pritesh06303/2505_DataLogger/Input/Specification.docx

Project Name: Humidity Data Logger
Company: Innovation Device Solution (IDS)
Version: V0.0
Date: 23-09-2025

1. General Information

Parameter | Requirement
Device Type | Humidity & Temperature Data Logger
End Applications | Environmental monitoring, Industrial process, Agriculture, Storage/Cold Chain
Enclosure Rating | IP54 minimum
Compliance | CE / RoHS / EMC (IEC 61000-4-2/3)

2. Sensor Specifications

Parameter | Requirement
Sensor Model | TI HDC3022
Humidity Range | 0–100 %RH
Humidity Accuracy | ±2 %RH (20–80 %RH)
Humidity Resolution | 0.01 %RH
Temperature Range | -20 °C to +85 °C
Temperature Accuracy | ±0.5 °C (0–60 °C)
Temperature Resolution | 0.01 °C
Step Response (τ) | 4 s (63% RH step, moving air)
Long-Term Drift | ≤0.19 %RH/year

3. Logging & Storage

Parameter | Requirement
Logging Interval | 5s – 1 hr (configurable)
Memory Capacity | ≥64,000 readings
Data Type | Humidity, Temperature, Timestamp
RTC | Integrated with battery backup

4. Power & Battery

Parameter | Requirement
Battery Type | CR2450/2032 Coin Cell
Typical Battery Life | ≥1 year @ 15 min logging interval
Indicators | Low Battery Warning

5. User Interface

Parameter | Requirement
Display | LCD 3 ½ showing RH, Temp, Status
Buttons | 2 Keys (Start/Stop, Min/Max)
LED Indicators | Logging, Battery Low

6. Connectivity

Parameter | Requirement
USB | USB 2.0 (data transfer & config)
Data Export | CSV / PDF via PC Software

7. Software

Parameter | Requirement
IDS Logger PC Software | Configuration, Data Download, Visualization

8. Environmental Conditions

Parameter | Requirement
Operating Temp | -20 °C to +60 °C
Operating Humidity | 0–95 %RH (non-condensing)
Storage Conditions | -30 °C to +70 °C
