pritesh06303/2505_DataLogger/Input/IDS_Humidity_DataLogger.docx

Project Requirement Document (PRD)

Project Title: Humidity Data Logger
Company: Innovation Device Solution (IDS)
Prepared By:
Date: 23-09-2025

1. Introduction

The Humidity Data Logger is a compact, battery-powered device designed for environmental monitoring, industrial processes, agriculture, and storage applications. It integrates the HDC3022 humidity and temperature sensor for high accuracy and long-term stability.

2. Objectives

- Develop a reliable humidity and temperature data logger with ±2 %RH and ±0.5 °C accuracy.
- Ensure low-power operation for long battery life (minimum 1 year typical).
- Provide on-device storage (min. 64,000 readings) and USB for data retrieval.
- LCD 3 ½ digit for real-time monitoring.
- Enable calibration and firmware upgrade capability.

3. System Overview

The system consists of:

- Sensing Unit: HDC3022 sensor for humidity & temperature.
- Processing Unit: Low-power microcontroller (STM32L4 /U0).
- Data Storage: External EEPROM for at least 64000(32000 Temp +32000 % RH) logs.
- User Interface: LCD 3 ½ digit, 2-button keypad.
- Power Supply: Coin cell (CR 2450 or CR 2032)
- Connectivity: USB 2.0.
- Enclosure: Portable, vented for accurate humidity measurement – Mechanical

4. Functional Requirements

4.1 Measurement

- Humidity Range: 0–100 %RH
- Humidity Accuracy: ±2 %RH (20–80 %RH)
- Temperature Range: -20 °C to +60 °C
- Temperature Accuracy: ±0.1 °C (0–60 °C)
- Step Response (τ): 4 s (in moving air, 63% RH change)
- Resolution: 0.01 %RH / 0.01 °C

4.2 Logging & Storage

- Logging Interval: 5 s – 1 hr (configurable)
- Storage Capacity: ≥64,000 records (humidity + temperature + timestamp)
- Real-Time Clock (RTC) with battery backup

4.3 Power & Battery

- Battery Type: CR2450 /CR2032 coin cell
- Typical Battery Life: ≥1 year at 15 min logging interval
- Low-battery indication

4.4 User Interface

- LCD display: LCD 3 ½ digit showing Humidity, Temperature, Status
- Keypad: 2 buttons (Start/Stop , Min/Max)
- LED indication: Logging, Battery Low

4.5 Data Transfer

- USB 2.0 direct connection to PC
- Data format: CSV/PDF export via software

4.6 Software

- Logger PC software for data download, configuration, and visualization
- Firmware upgrade via USB

5. Non-Functional Requirements

- Operating Environment: -20 °C to +60 °C, 0–95 %RH non-condensing
- IP54 minimum enclosure, option for IP67 with sealed design
- EMC/ESD compliance (IEC 61000-4-2/3)
- Calibration certificate traceable to ISO 17025 (optional)

6. Deliverables

- Final product hardware design (schematic, PCB, enclosure)
- Firmware with logging, display, and communication features
- Logger PC software package
- Production test plan & calibration procedure
- User manual & datasheet

7. Timeline

- Week 1: Requirement freeze & block diagram
- Week 2-3: Hardware design & prototype
- Week 3-7: Firmware development & testing
- Week 8-10: Field testing & calibration
- Week11: Final release

8. Success Criteria

- Meets specified accuracy (±2 %RH, ±0.5 °C)
- Logs data continuously for ≥1 year battery life
- Easy data export to PC via USB
- Robust enclosure suitable for industrial and agricultural environments
