pritesh06303/2505_DataLogger/2505_IDS_DL_BAT_HW/Project Outputs for 2505_IDS_DL_BAT/BOM_2505_IDS_DL_BAT.xlsx

Sheet: BOM_2505_IDS_DL_BAT
Sr.No | Comment | Designator | Quantity | Manufacturer Name | Manufacturer Part No | Total Qty 10 | Total Qty 25 | Total Qty 50 | Total Qty 100 | Total Qty 500 | Total Qty 1000 | Price@10 | Price@25 | Price@50 | Price@100 | Price@500 | Price@1000 | Total Price@10 | Total Price@25 | Total Price@50 | Total Price@100 | Total Price@500 | Total Price@1000
1 | CAP CER 0.1UF 50V X7R 0603 | C1, C3, C4, C5, C6, C10, C11 | 7 | Samsung Electro-Mechanics | CL10B104KB8NNWC | 70 | 175 | 350 | 700 | 3500 | 7000 | 0.315 | 0.28 | 0.28 | 0.28 | 0.28 | 0.21 | 22.05 | 49 | 98 | 196 | 980 | 1470
2 | CAP CER 1UF 50V X7R 0805 | C2, C9, C12, C13 | 4 | Samsung Electro-Mechanics | CL21B105KBFNNNE / CL10A105KA8NNNC | 40 | 100 | 200 | 400 | 2000 | 4000 | 0.438 | 0.3763 | 0.3763 | 0.3763 | 0.3763 | 0.35 | 17.52 | 37.63 | 75.26 | 150.52 | 752.6 | 1400
3 | CAP CER 10PF 50V C0G/NP0 0603 | C7, C8 | 2 | Walsin Technology Corporation | 0603N100J500CT | 20 | 50 | 100 | 200 | 1000 | 2000 | 2.1 | 1.3826 | 1.1813 | 1.1813 | 0.721 | 0.721 | 42 | 69.13 | 118.13 | 236.26 | 721 | 1442
4 | DIODE SCHOTTKY 20V 1A SOD323 | D1, D6 | 2 | Nexperia USA Inc. | PMEG2010BEA | 20 | 50 | 100 | 200 | 1000 | 2000 | 19.25 | 19.25 | 11.655 | 11.655 | 7.39025 | 7.39025 | 385 | 962.5 | 1165.5 | 2331 | 7390.25 | 14780.5
5 | LED RED CLEAR SMD | D2, D3 | 2 |  |  | 20 | 50 | 100 | 200 | 1000 | 2000 | 7.963 | 7.963 | 5.5038 | 5.5038 | 4.347 | 3.962 | 159.26 | 398.15 | 550.38 | 1100.76 | 4347 | 7924
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
26 | Box Final Assembly |  | 1 |  |  | 10 | 25 | 50 | 100 | 500 | 1000 | 150 | 150 | 150 | 150 | 150 | 150 | 1500 | 3750 | 7500 | 15000 | 75000 | 150000
 |  |  |  |  |  |  |  |  |  |  |  |  |  |  |  |  | Total BOM Cost | 19526.67 | 44864.16 | 86139.87 | 162929.08 | 711589.22 | 1357342.42
 |  |  |  |  |  |  |  |  |  |  |  |  |  |  |  |  | Price /PCB | 1952.67 | 1794.57 | 1722.80 | 1629.29 | 1423.18 | 1357.34
 |  |  |  |  |  |  |  |  |  |  |  |  |  |  |  | PCB + Courier Charge |  | 20.00 | 26.68 | 37.38 | 62.02 | 181.04 | 327.85
 |  |  |  |  |  |  |  |  |  |  |  |  |  |  |  | Duty on PCB | 30% | 6.00 | 8.00 | 11.21 | 18.61 | 54.31 | 98.36
 |  |  |  |  |  |  |  |  |  |  |  |  |  |  |  | Surcharge | 15% | 0.90 | 1.20 | 1.68 | 2.79 | 8.15 | 14.75
 |  |  |  |  |  |  |  |  |  |  |  |  |  |  |  | SGST | 18% | 1.24 | 1.66 | 2.32 | 3.85 | 11.24 | 20.36
 |  |  |  |  |  |  |  |  |  |  |  |  |  |  |  | Total Surcharge |  | 8.14 | 10.86 | 15.22 | 25.25 | 73.70 | 133.47
 |  |  |  |  |  |  |  |  |  |  |  |  |  |  |  | Total PCB Price |  | 28.14 | 37.54 | 52.60 | 87.27 | 254.74 | 461.32
 |  |  |  |  |  |  |  |  |  |  |  |  |  |  |  | Price/ PCB |  | 2.81 | 1.50 | 1.05 | 0.87 | 0.51 | 0.46
 |  |  |  |  |  |  |  |  |  |  |  |  |  |  |  | USD Price | 88 | 247.65 | 132.15 | 92.57 | 76.80 | 44.83 | 40.60
 |  |  |  |  |  |  |  |  |  |  |  |  |  |  |  |  | 2476.496
 |  |  |  |  |  |  |  |  |  |  |  |  |  |  |  |  | 40 | 781.06696 | 717.8264906 | 689.1189682 | 651.7163124 | 569.2713774 | 542.9369683
 |  |  |  |  |  |  |  |  |  |  |  |  |  |  |  |  | Total Price | 2733.73436 | 2512.392717 | 2411.916389 | 2281.007093 | 1992.449821 | 1900.279389
 |  |  |  |  |  |  |  |  |  |  |  |  |  |  |  |  |  | 781066.96 | 717826.4906 | 689118.9682 | 651716.3124 | 569271.3774 | 542936.9683
 |  |  |  |  |  |  |  |  |  |  |  |  |  |  |  |  |  | 158.1011734 | 8.09667706
 |  |  |  |  |  |  |  |  |  |  |  |  |  |  |  |  |  | 229.8699795 | 11.77210105
 |  |  |  |  |  |  |  |  |  |  |  |  |  |  |  |  |  | 323.376619 | 16.56076294
 |  |  |  |  |  |  |  |  |  |  |  |  |  |  |  |  |  | 529.4889564 | 27.11618765 |  | S
 |  |  |  |  |  |  |  |  |  |  |  |  |  |  |  |  |  | 595.3249793 | 30.48778196

Sheet: BOM_2505_IDS_DL_PROD
Sr.No | Comment | Designator | Quantity
1 | CAP CER 0.1UF 50V X7R 0603 | C1, C3, C4, C5, C6, C10, C11 | 7
2 | CAP CER 1UF 50V X7R 0805 | C2, C9, C12, C13 | 4
3 | CAP CER 10PF 50V C0G/NP0 0603 | C7, C8 | 2
4 | DIODE SCHOTTKY 20V 1A SOD323 | D1, D6 | 2
5 | LED RED CLEAR SMD | D2, D3 | 2
7 | TVS DIODE 5.5VWM 8.5VC SOT23-5 | D5 | 1
8 | USB-C REC 3" VERT 24P SMT & TH S | J1 | 1
10 | RES 100K OHM 1% 1/10W 0603 | R1 | 1
11 | RES 0 OHM JUMPER - 0402 | R2, R13, R16 | 3
12 | RES 10K OHM 1% 1/10W 0603 | R3, R4, R5, R6, R7, R8, R9, R10 | 8
13 | RES 1M OHM 1% 1/10W 0603 | R11, R12 | 2
14 | RES 5.1K OHM 1% 1/10W 0603 | R14, R15 | 2
15 | SWITCH TACTILE SPST-NO 0.05A 12V | SW1, SW2 | 2
16 | CONN HEADER VERT 5POS 2.54MM | SWD1 | 1
17 | IC MCU STM32U083RCT6 64LQFP | U1 | 1
18 | IC EEPROM 8MBIT SPI/QUAD 8SOIC | U2 | 1
19 | RH DIGITAL HUMIDITY SENSOR | U3 | 1
20 | IC REG LINEAR 3.3V 150MA SMV | U4 | 1
21 | CRYSTAL 32.7680KHZ 7PF SMD | X1 | 1
22 | PCB |  | 1
