pritesh06303/2505_DataLogger/Input/CST-2450P.stp

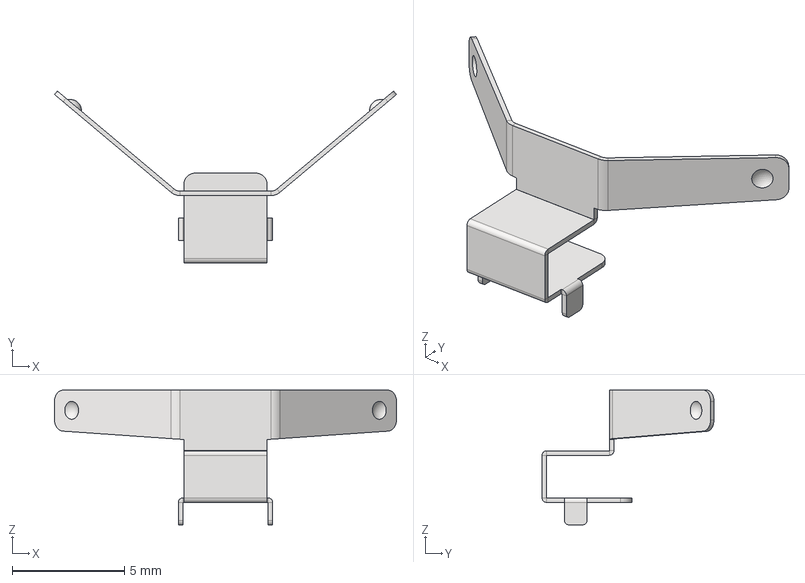
[picture p1: CAD file, 2025-11-02]
Input/CST-2450P.stp
15.2 x 7.65 x 6.00 mm
