pritesh06303/2505_DataLogger/Input/Mechanical_Input/CS100-B.stp

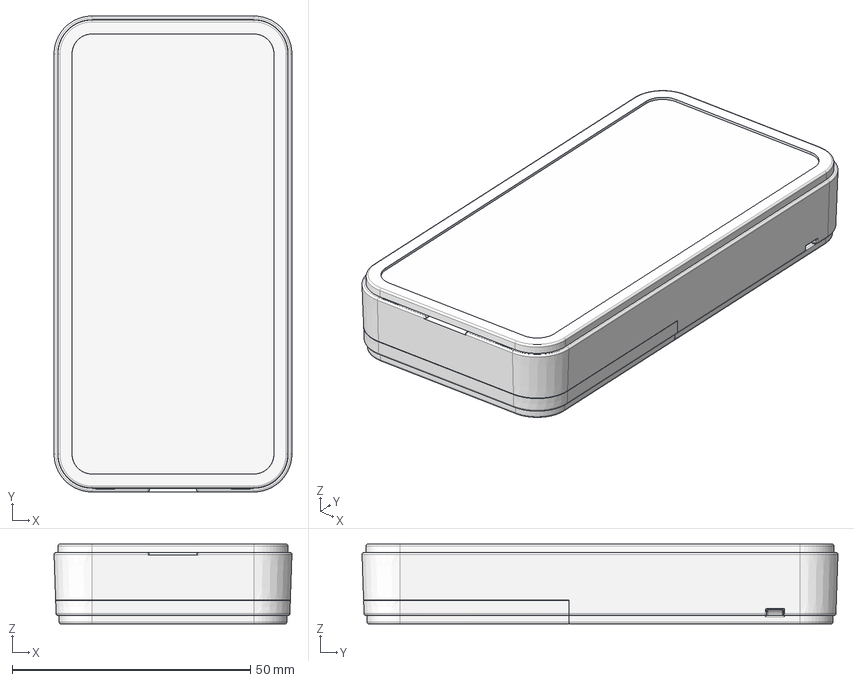
[picture p2: CAD file, 2025-11-02]
Input/Mechanical_Input/CS100-B.stp
50.0 x 100.0 x 16.8 mm
CS100 bottom cover_R
CS100 top cover
CS100 battery cover_R
ﾋﾞｽ M1.6×6 x 4
