pritesh06303/2505_DataLogger/Input/CST-2450M.stp

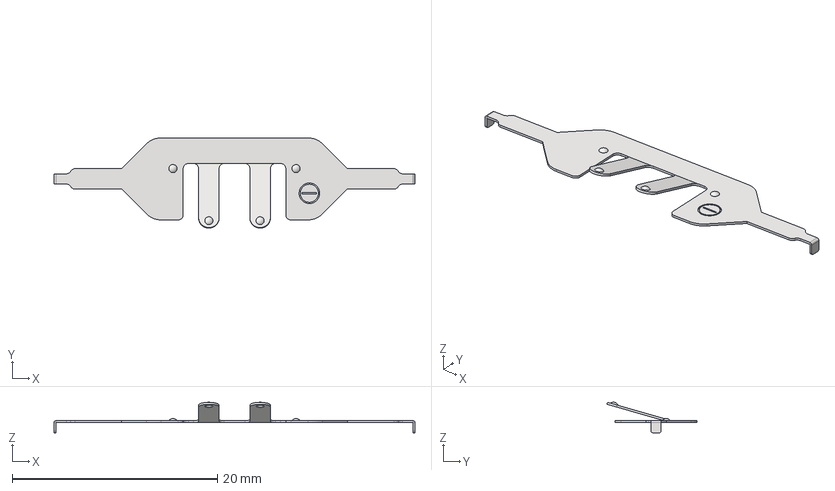
[picture p3: CAD file, 2025-11-02]
Input/CST-2450M.stp
35.2 x 8.80 x 3.00 mm
