pritesh06303/2505_DataLogger/Input/Mechanical_Input/CSPB-100_PCB.stp

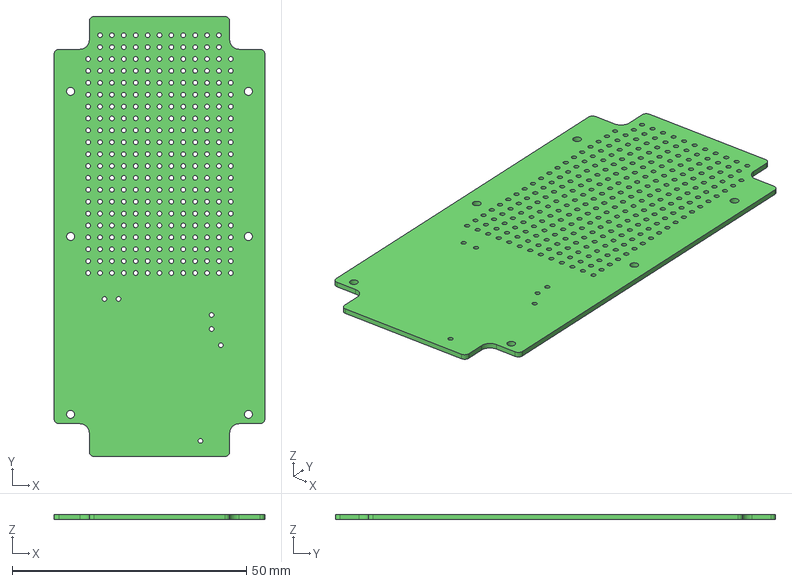
[picture p4: CAD file, 2025-11-02]
Input/Mechanical_Input/CSPB-100_PCB.stp
45.0 x 94.0 x 1.00 mm
