pritesh06303/2505_DataLogger/(list of files, cad)

Other CAD files:
Input/CST-2450M.dwg
Input/CST-2450P.dwg
Input/Mechanical_Input/CS100-B.dwg
Input/Mechanical_Input/CS100-B.dxf
Input/Mechanical_Input/CSPB-100_PCB.dwg
Input/Mechanical_Input/CSPB-100_PCB.dxf
