pritesh06303/2505_DataLogger/2505_IDS_DL_BAT_HW/2505_IDS_DL_BAT.pdf

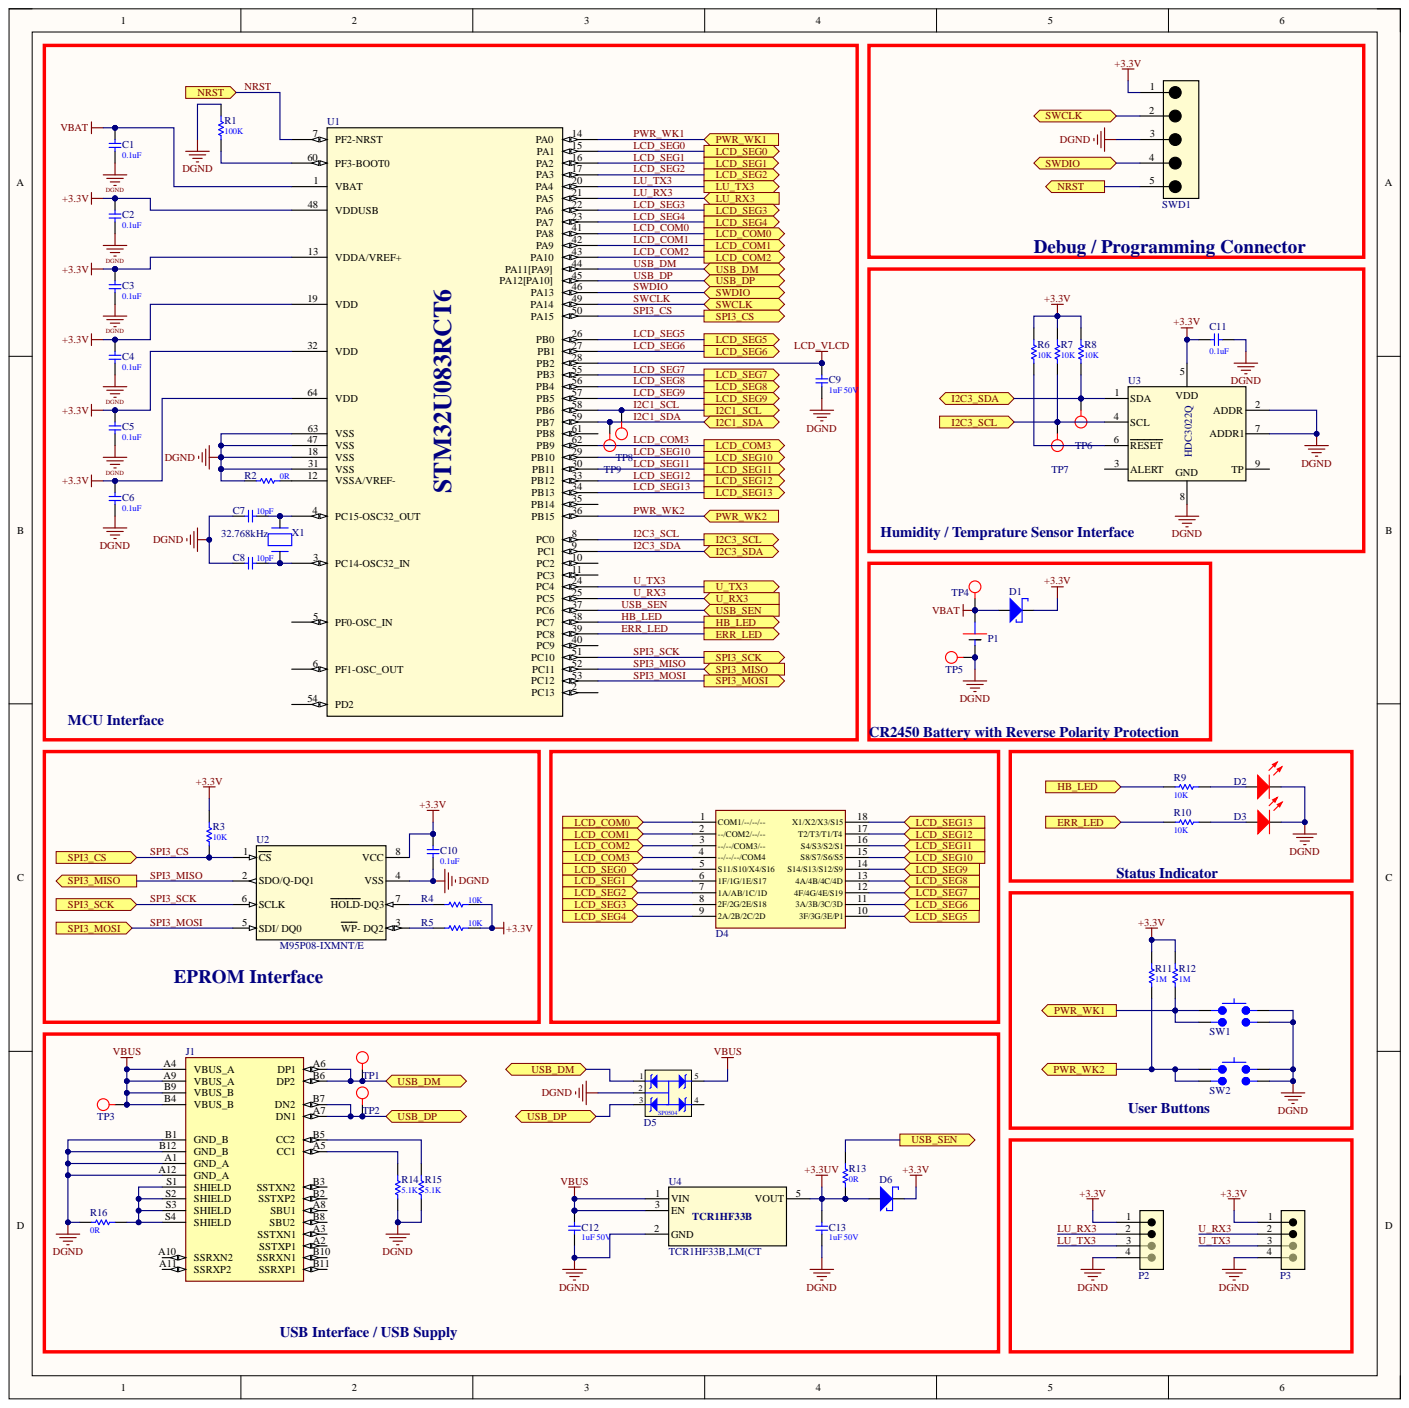
[picture p5: page 1]

VDD 32 | SPI3_CS

DGND | LCD_SEG5

VSS 47 VSS 63

VSS 18 | LCD_SEG10

R2 0R | | VSSA/VREF- 12 | LCD_SEG12

Humidity / Temprature Sensor Interface

CR2450 Battery with Reverse Polarity Protection

USB Interface / USB Supply
