pritesh06303/2505_DataLogger/(list of files, drawings)

Other design files:
2505_IDS_DL_BAT_HW/2502_IDS_TransMax_PWM_Digital.SchDoc
2505_IDS_DL_BAT_HW/2505_IDS_DL_BAT.PrjPcb
2505_IDS_DL_BAT_HW/2505_IDS_DL_BAT.SchDoc
