pritesh06303/2505_DataLogger/2505_DataLogger_FW/IDLog/IDLog.ioc

Mcu.UserName=STM32U083RCTx
PA1.Signal=LCD_SEG0
PA10.Signal=LCD_COM2
PA15.GPIO_Label=EEPROM_CS
PA15.Signal=GPIO_Output
PA2.Signal=LCD_SEG1
PA3.Signal=LCD_SEG2
PA6.Signal=LCD_SEG3
PA7.Signal=LCD_SEG4
PA8.Signal=LCD_COM0
PA9.Signal=LCD_COM1
PB0.Signal=LCD_SEG5
PB1.Signal=LCD_SEG6
PB10.Signal=LCD_SEG10
PB11.Signal=LCD_SEG11
PB12.Signal=LCD_SEG12
PB13.Signal=LCD_SEG13
PB3.Signal=LCD_SEG7
PB4.Signal=LCD_SEG8
PB5.Signal=LCD_SEG9
PB9.Signal=LCD_COM3
PC0.Signal=I2C3_SCL
PC1.Signal=I2C3_SDA
PC10.Signal=SPI3_SCK
PC11.Signal=SPI3_MISO
PC12.Signal=SPI3_MOSI
PC3.Signal=LCD_VLCD
PC7.GPIO_Label=HB_LED
PC7.Signal=GPIO_Output
PC8.GPIO_Label=ERR_LED
PC8.Signal=GPIO_Output
