pritesh06303/2505_DataLogger/2505_DataLogger_FW/IDLog/Core/Inc/main.h

#define HB_LED_Pin GPIO_PIN_7
#define HB_LED_GPIO_Port GPIOC
#define ERR_LED_Pin GPIO_PIN_8
#define ERR_LED_GPIO_Port GPIOC
#define EEPROM_CS_Pin GPIO_PIN_15
#define EEPROM_CS_GPIO_Port GPIOA
