pritesh06303/2505_DataLogger/2505_DataLogger_FW/IDLog/Core/Src/Power_Management/BatMesure.h

/*
 * BatMesure.h
 *
 *  Created on: Nov 4, 2025
 *      Author: TITHI
 */

#ifndef SRC_POWER_MANAGEMENT_BATMESURE_H_
#define SRC_POWER_MANAGEMENT_BATMESURE_H_

extern float batvolt;

bool Read_Vbat_Reading(float *value);

#endif /* SRC_POWER_MANAGEMENT_BATMESURE_H_ */
