pritesh06303/2505_DataLogger/(commit log)

2025-11-01 Create Project
    - Create Project
    - Added HDC, EEPROM and Timer files.
    - Generate 1-Milli Second Timer and Verified.
    - Verification Pending.
2025-11-01 HW Project File Added
    [2502_IDS_TransMax_PWM_Digital.SchDoc, 2505_IDS_DL_BAT.PrjPcb, 2505_IDS_DL_BAT.SchDoc, BOM_2505_IDS_DL_BAT.xlsx, CS100-B.dwg, CS100-B.dxf, CS100-B.stp, CSPB-100_PCB.dwg]
2025-11-02 EEPROM and Humidity Sensor Verify.
    - Update Timer Period Value
    - EEPROM and Humidity Sensor Verify.
2025-11-09 Implement LCD Code
    - Implement code for internal display driver.
    - Display Temperature and RH Data On LCD.
    - Read Sensor data every 5 second and update on LCD.
