pritesh06303/2505_DataLogger/(notices)

Notices in the files:
2505_DataLogger_FW/IDLog/Core/Inc/main.h:
Copyright (c) 2025 STMicroelectronics.
All rights reserved.
This software is licensed under terms that can be found in the LICENSE file
